Hermiedapwdrman/CH_Fishinator/firmware/samd_pio_src/ReadMe_Firmware_SAMD.md

##TO DO: Explain SAMD21 project src structure readme
1. Explaing how to init project via clion and platformio
2. Make some suggestions for configuring
3. Notes on commiting and tracking changes (ala esp32 readme)
4. profit!
