Hermiedapwdrman/CH_Fishinator/hardware/LogicBoard/BOM_LogicBoard.ods

Description: | Amount: | Manufacturer: | Manufacturer PN:Digikey | Other PN: | Website:
Boards, cables and and mechanics:
Esp pico kit v4 | 1 | Espressif – Electrodragon | NWI1145 |  | http://www.electrodragon.com/product/esp32-pico-kit-dev-board-v4/
Sparkfun SAMD21 mini break out board | 1 | Sparkfun Atmel | 13664 |  | https://www.sparkfun.com/products/13664
Ion Roboclaw 15A Motor Controller | 1 | Ion Motion Control | IMC412 |  | http://www.ionmc.com/RoboClaw-2x15A-Motor-Controller_p_10.html
1 ft cat 6e patch cable – shielded | 1 | Monoprince | 5898 |  | https://www.monoprice.com/product?p_id=5901
6ft USB A-B cable | 1 | Amazon |  |  | https://www.amazon.com/gp/product/B00UNZ9KBM/ref=oh_aui_detailpage_o01_s00?ie=UTF8&psc=1
1F USB A to micro | 1 |  |  |  | https://www.amazon.com/gp/product/B011KMSNXM/ref=oh_aui_detailpage_o01_s00?ie=UTF8&psc=1
Electronic components.
CUI AMT encoder wide base | 1 | CUI | AMT-B1-W | 102-3323-ND | https://www.digikey.com/products/en?keywords=102-3323-ND
CUI AMT-203 encoder | 1 | CUI | 102-2050-ND | 102-2050-ND | https://www.digikey.com/products/en/sensors-transducers/encoders/507?k=cui%20amt-203
USB Panel Adapter | 1 |  | SAM8637-ND |  | https://www.digikey.com/product-detail/en/samtec-inc/SCRU-02/SAM8637-ND/1785888
1uf 0603 capacitor | 3 | Taiyo Yuden | 587-2400-1-ND | UMK107BJ105KA-T | https://www.digikey.com/product-detail/en/taiyo-yuden/UMK107BJ105KA-T/587-2400-1-ND/2179013
0.1uf 0603 capacitor | 3 | Murata | 490-11917-1-ND |  | https://www.digikey.com/product-detail/en/samsung-electro-mechanics/CL10B104KB8SFNC/1276-1936-1-ND/3890022
10uf 1205 capacitor | 2 | Taiyo Yuden | 587-3248-1-ND | UMK316BBJ106ML-T | https://www.digikey.com/product-detail/en/murata-electronics-north-america/GRM155R61H104KE19D/490-11917-1-ND/5360889
470uf Through Elec. Capacitor | 1 | Panasonic elec. Components | P5185-ND | ECA-1HM471 | https://www.digikey.com/products/en/capacitors/aluminum-electrolytic-capacitors/58?k=p5185
Terminal blocks 2 position | 2 |  | 281-1414-ND | 1715250000 | https://www.digikey.com/products/en?keywords=281-1414
2x female square header socket | 2 | PRT-00115 |  |  | https://www.sparkfun.com/products/115
2x7 1.27mm fem header | 1 | Minitek | 20021311-00014T4LF | 609-3756-ND | https://www.digikey.com/product-detail/en/amphenol-fci/20021311-00014T4LF/609-3756-ND/2209089
RJ45 jack/socket, ethernet jack | 2 | Assamann WSW | A-2004-2-4-LPS-N-R | AE10387-ND | https://www.digikey.com/product-detail/en/assmann-wsw-components/A-2004-2-4-LPS-N-R/AE10387-ND/2183638
15.8k 0603 resistor | 1 |  | 311-15.8KHRCT-ND | RC0603FR-0715K8L | https://www.digikey.com/product-detail/en/yageo/RC0603FR-0715K8L/311-15.8KHRCT-ND/729904
33k resistor pack | 1 |  | 742C163333JPCT-ND |  | https://www.digikey.com/product-detail/en/cts-resistor-products/742C163333JP/742C163333JPCT-ND/1124501
Bss138P Transistor | 1 | Nexperia | 1727-1142-1-ND | BSS138P,215 | https://www.digikey.com/product-detail/en/nexperia-usa-inc/BSS138P215/1727-1142-1-ND/4162471
CSD Next fet Nfet transistor | 1 | Texes Inst. | 296-35628-1-ND | CSD18532Q5B | https://www.digikey.com/product-detail/en/texas-instruments/CSD18532Q5B/296-35628-1-ND/3854689
85V shottkey diode | 1 | Diodes inc. | MBR0580S1-7DICT-ND |  | https://www.digikey.com/product-detail/en/diodes-incorporated/MBR0580S1-7/MBR0580S1-7DICT-ND/5080371
