Hermiedapwdrman/CH_Fishinator/hardware/EncoderBoard/BOM_EncoderBoard.ods

Description: | Amount: | Manufacturer: | Manufacturer PN | Digikey or other PN: | Website:
2x7 1.27mm fem header | 1 | Minitek | 20021311-00014T4LF | 609-3756-ND | https://www.digikey.com/product-detail/en/amphenol-fci/20021311-00014T4LF/609-3756-ND/2209089
RJ45 jack/socket, ethernet jack | 1 | Assamann WSW | A-2004-2-4-LPS-N-R | AE10387-ND | https://www.digikey.com/product-detail/en/assmann-wsw-components/A-2004-2-4-LPS-N-R/AE10387-ND/2183638
1 ft cat 6e patch cable – shielded | 1 | Monoprince | 5898 |  | https://www.monoprice.com/product?p_id=5901
Esp pico kit v4 | 1 | Espressif – Electrodragon |  | NWI1145 | http://www.electrodragon.com/product/esp32-pico-kit-dev-board-v4/
