Hermiedapwdrman/CH_Fishinator/TODO.md

TODO: Example project for new organization

# A heading
## A sub heading

'Code snippet'
