Hermiedapwdrman/CH_Fishinator/hardware/LogicBoard/LogicBoard_ESP_SAMD.brd

## EAGLE design hardware/LogicBoard/LogicBoard_ESP_SAMD.brd (2018-03-26)

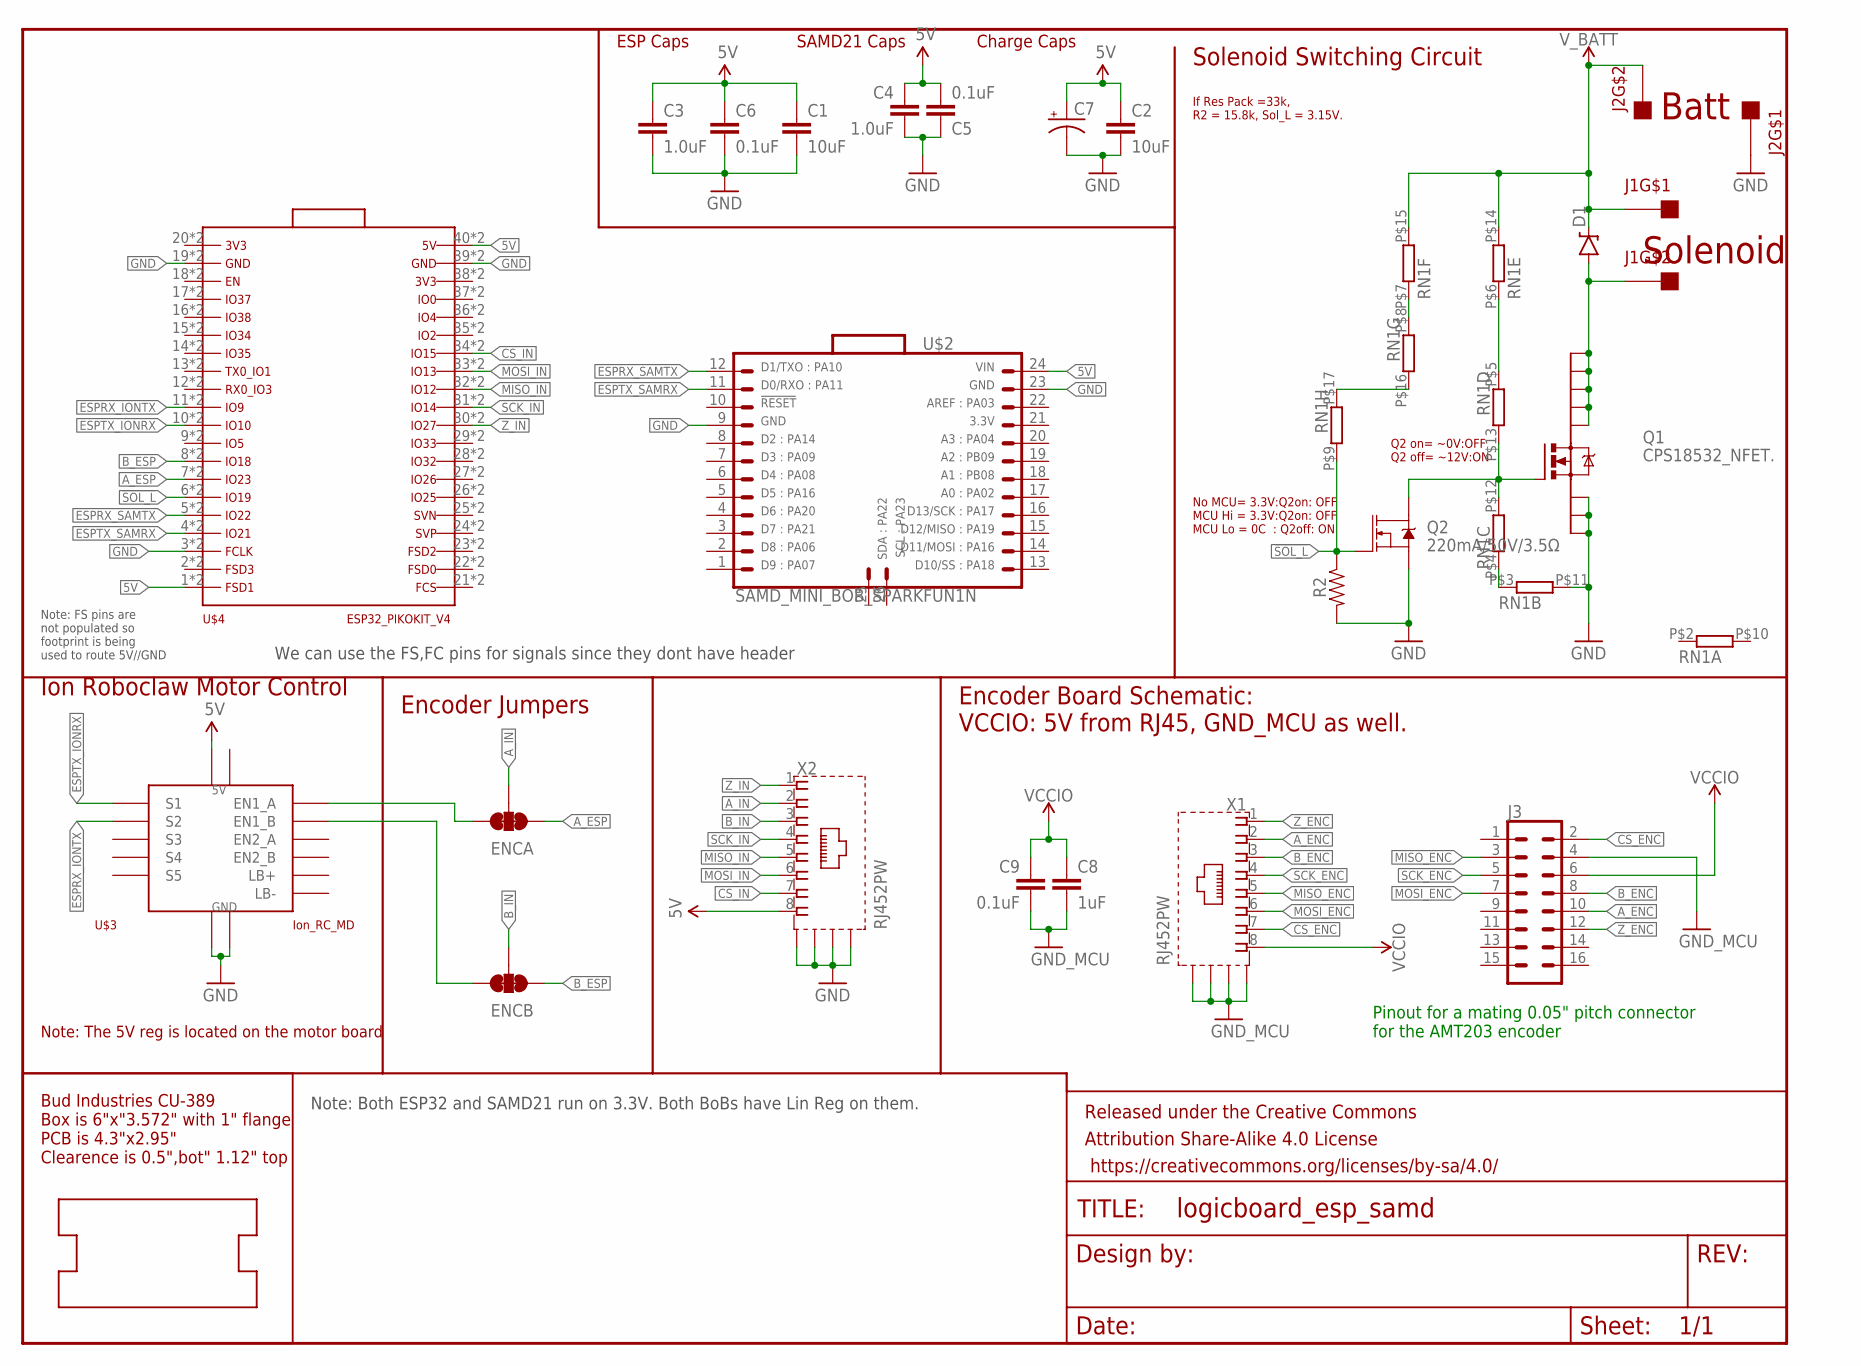
[picture p1: schematic LogicBoard_ESP_SAMD.sch]

Parts:
C1, C2: 10uF; 1206
C3, C4: 1.0uF; 0603
C5, C6, C9: 0.1uF; 0603
C7: CAP_POLPTH4; CPOL-RADIAL-1000UF-25V
C8: 1uF; 0603
D1: DIODE-SHOTKEY_SOD-123; SOD-123_MINI-SMA
ENCA: JUMPER-SMT_3_2-NC_TRACE_SILK; SMT-JUMPER_3_2-NC_TRACE_SILK
ENCB: JUMPER-SMT_3_2-NC_TRACE_SILK; SMT-JUMPER_3_2-NC_TRACE_SILK
FRAME1: FRAME-LETTERNO_PACKAGE; DUMMY
J1, J2: M2_TERMINAL_0200SPACING; M2_0200
J3: CONN_08X2_1.27MM; 2X08_1.27MM
Q1: CPS18532_NFET.; CSD18532_NFET_NEXTFET
Q2: 220mA/50V/3.5Ω; SOT23-3
R2: 0603
RN1: RESISTOR-DIL_8R-N742C163; RESISTOR-DIL_742C163
U$1: BOX_BUDIND_CU389STENCIL; BOX_BUDIND_CU389_STENCIL
U$2: SAMD_MINI_BOB_SPARKFUN1N; SAMD_MINI_BOB_SF_NOLABEL
U$3: ION_ROBOCLAW_MOTORDRVTOPVIEW; ION_ROBOCLAW_MOTORCNTL
U$4: ESP32_PICOKIT_V42N; ESP32_PICOKIT_2N
X1, X2: RJ452PW; RJ45-SHIELD1

Connections:
5V: C1.1, C2.1, C3.1, C4.1, C5.2, C6.1, C7.1 (+), U$2.24 (VIN), U$3.5V@1 (5V), U$3.5V@2 (5V), U$3.5V@3 (5V), U$3.5V@4 (5V), U$3.5V@5 (5V), U$4.1, U$4.40, U$4.41, U$4.80, X2.8
!SOL_L!: Q2.1 (G), R2.1, RN1.P$9 (2), U$4.6, U$4.46
A_ENC: J3.10, X1.2
A_ESP: ENCA.1, U$4.7, U$4.47
A_IN: ENCA.2, X2.2
B_ENC: J3.8, X1.3
B_ESP: ENCB.1, U$4.8, U$4.48
B_IN: ENCB.2, X2.3
CS_ENC: J3.2, X1.7
CS_IN: U$4.34, U$4.74, X2.7
ESPRX_IONTX: U$3.S2, U$4.11, U$4.51
ESPRX_SAMTX: U$2.12 (D1), U$4.5, U$4.45
ESPTX_IONRX: U$3.S1, U$4.10, U$4.50
ESPTX_SAMRX: U$2.11 (D0), U$4.4, U$4.44
GND: C1.2, C2.2, C3.2, C4.2, C5.1, C6.2, C7.2 (-), J2.P$2, Q1.P$1 (S1), Q1.P$2 (S2), Q1.P$3 (S3), Q2.2 (S), R2.2, RN1.P$11 (2), U$2.9 (GND), U$2.23 (GND), U$3.GND@1 (GND), U$3.GND@2 (GND), U$3.GND@3 (GND), U$3.GND@4 (GND), U$3.GND@5 (GND), U$3.GND@6 (GND), U$3.GND@7 (GND), U$4.3, U$4.19, U$4.39, U$4.43, U$4.59, U$4.79, X2.S1 (S), X2.S2 (S), X2.S3 (S), X2.S4 (S)
GND_MCU: C8.2, C9.2, J3.4, X1.S1 (S), X1.S2 (S), X1.S3 (S), X1.S4 (S)
MISO_ENC: J3.3, X1.5
MISO_IN: U$4.32, U$4.72, X2.5
MOSI_ENC: J3.7, X1.6
MOSI_IN: U$4.33, U$4.73, X2.6
unnamed: D1.A, J1.P$3, Q1.P$5 (D1), Q1.P$6 (D2), Q1.P$7 (D3), Q1.P$8 (D4), Q1.P$9 (D_PAD)
unnamed: RN1.P$3 (1), RN1.P$4 (1)
unnamed: Q1.P$4 (G), Q2.3 (D), RN1.P$12 (2), RN1.P$13 (2)
unnamed: RN1.P$7 (1), RN1.P$8 (1)
unnamed: RN1.P$16 (2), RN1.P$17 (1)
unnamed: RN1.P$5 (1), RN1.P$6 (1)
unnamed: ENCB.3, U$3.EN1_B
unnamed: ENCA.3, U$3.EN1_A
SCK_ENC: J3.5, X1.4
SCK_IN: U$4.31, U$4.71, X2.4
VCCIO: C8.1, C9.1, J3.6, X1.8
V_BATT: D1.C, J1.P$2, J2.P$3, RN1.P$14 (2), RN1.P$15 (2)
Z_ENC: J3.12, X1.1
Z_IN: U$4.30, U$4.70, X2.1

Notes on the sheet:
Note: Both ESP32 and SAMD21 run on 3.3V. Both BoBs have Lin Reg on them.
We can use the FS,FC pins for signals since they dont have header
Pinout for a mating 0.05" pitch connector for the AMT203 encoder
Encoder Board Schematic: VCCIO: 5V from RJ45, GND_MCU as well.
If Res Pack =33k, R2 = 15.8k, Sol_L = 3.15V.
Encoder Jumpers
Ion Roboclaw Motor Control
Note: The 5V reg is located on the motor board
Solenoid Switching Circuit
Solenoid
Batt
Q2 on= ~0V:OFF Q2 off= ~12V:ON
No MCU= 3.3V:Q2on: OFF MCU Hi = 3.3V:Q2on: OFF MCU Lo = 0C : Q2off: ON
ESP Caps
SAMD21 Caps
Charge Caps
Note: FS pins are not populated so footprint is being used to route 5V//GND

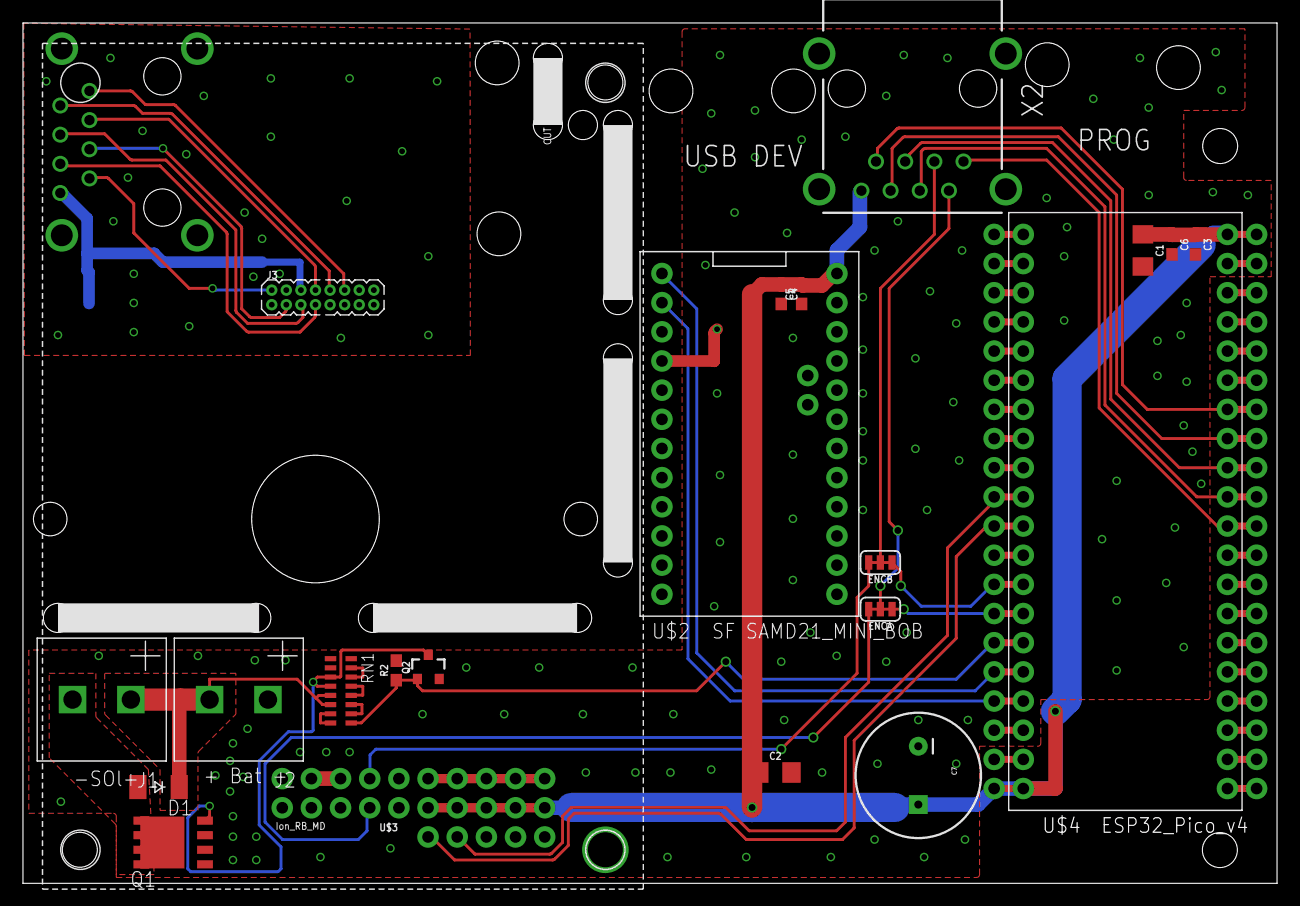
[picture p2: board LogicBoard_ESP_SAMD.brd from above]

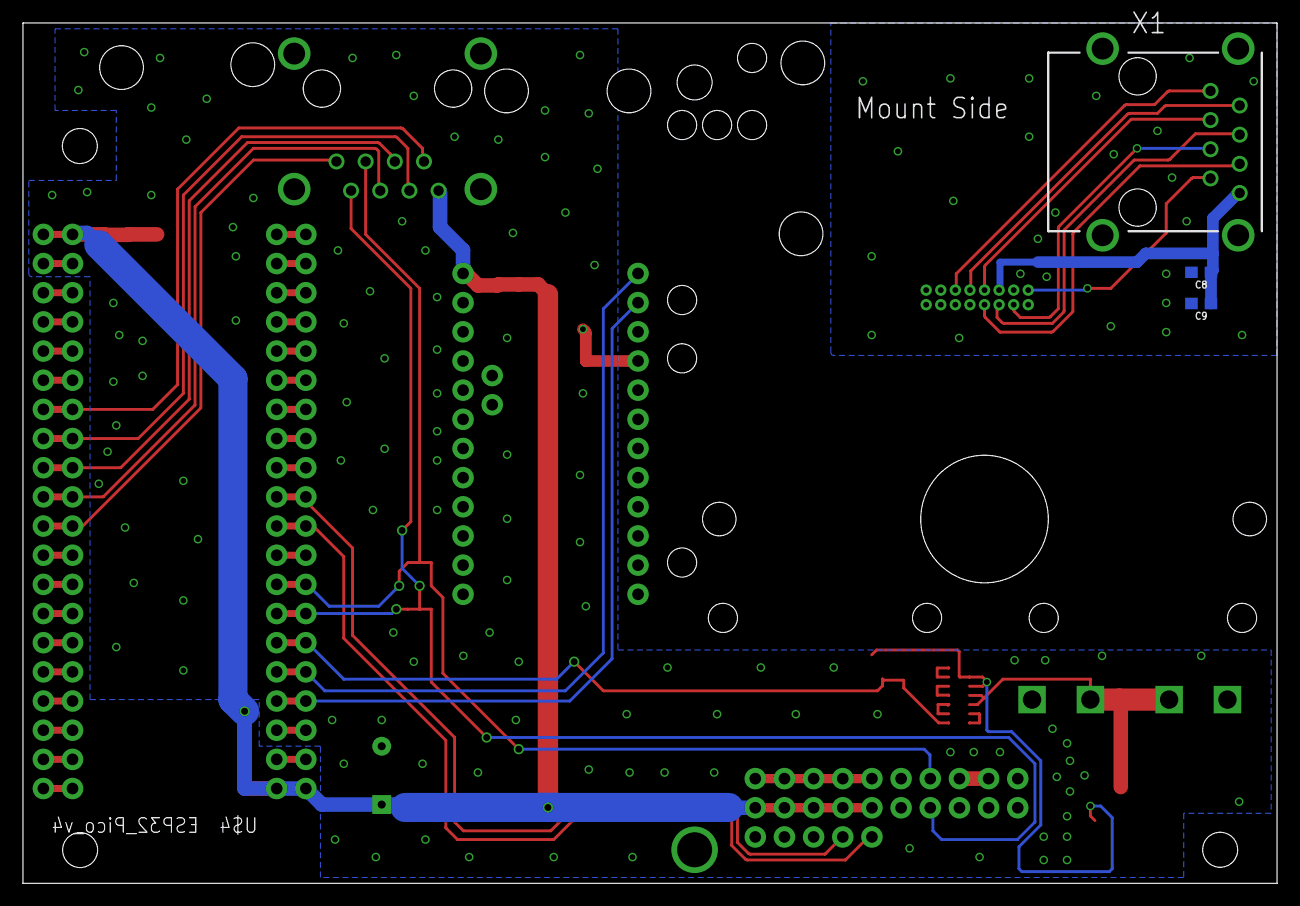
[picture p3: board LogicBoard_ESP_SAMD.brd from below]

Board: 2 copper layers, 109.2 x 74.9 mm, 27 parts (3 on the bottom side), 34 nets.

Other parts of the board:
FRAME2: FRAME-LETTERNO_PACKAGE; DUMMY
