Hermiedapwdrman/CH_Fishinator/hardware/EncoderBoard/EncAMT203_Cat6_180223.brd

## EAGLE design hardware/EncoderBoard/EncAMT203_Cat6_180223.brd (2018-02-27)

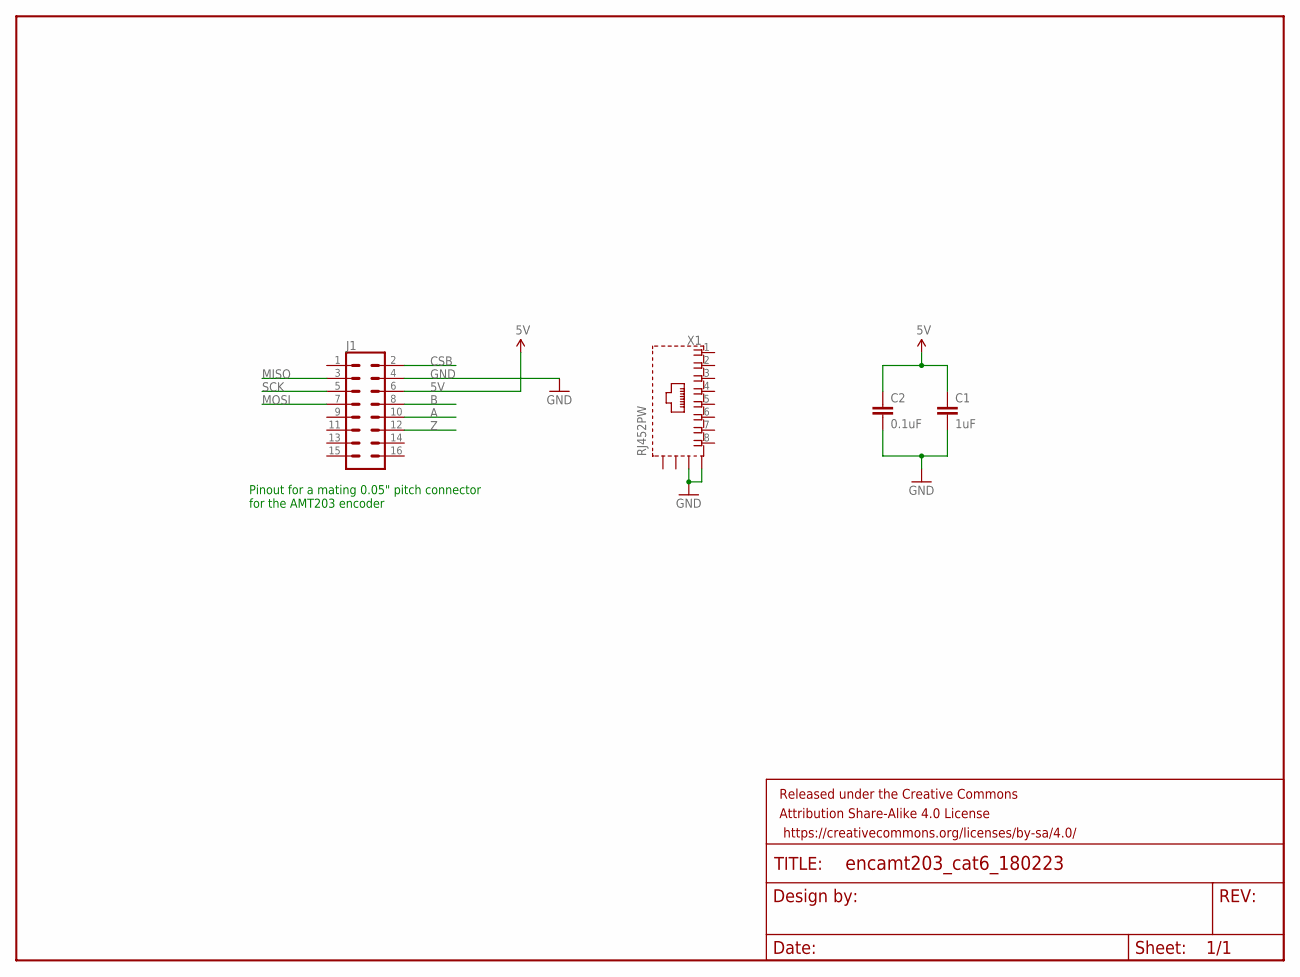
[picture p4: schematic EncAMT203_Cat6_180223.sch]

Parts:
C1: 1uF; 0603
C2: 0.1uF; 0603
FRAME1: FRAME-LETTERNO_PACKAGE; DUMMY
J1: CONN_08X2_1.27MM; 2X08_1.27MM
X1: RJ452PW; RJ45-SHIELD1

Connections:
5V: C1.1, C2.1, J1.6
A: J1.10
B: J1.8
CSB: J1.2
GND: C1.2, C2.2, J1.4, X1.S1 (S), X1.S2 (S)
MISO: J1.3
MOSI: J1.7
SCK: J1.5
Z: J1.12

Notes on the sheet:
Pinout for a mating 0.05" pitch connector for the AMT203 encoder

Board: 2 copper layers, 5 parts (3 on the bottom side), 2 nets, no tracks yet.
