Hermiedapwdrman/CH_Fishinator/(commit log)

2017-11-01 Initial commit for a combined LUFA/AT90 and ESP32 MCU project.
2017-11-01 Tested build for ESP32 files, it works.
2017-11-01 Updated esp32 git ignore.
2017-11-15 Clarified project names, and updated sdkconfig UART settings to run at 921600 for everthing!
2017-12-13 New initial commit: Using git submodules to track sdk versions and make code more'complete'
2017-12-20 Changed paths to local git repos of big esp32 sdks
2018-01-08 Updated configs and updated submodules to track certain maintainable branches
2018-01-09 Added raw motor_vpid code into project, added arduino pid library as component submodule.
2018-01-12 Updating submodules, moved VPID and Pid to its own library
2018-01-12 Fixed cmake indexer includes, commented out LOTS of non portable code: NEEDS TO BE FIXED
    [CHMotorDriver.cpp]
2018-01-22 Updated arduino to master branch and FF to current
2018-01-22 Updated edp-idf to newest, compaitble with arduino
2018-01-22 Updated arduino sdk
2018-02-02 Updated cmake idf includes for components drivers, changed and test built idf syntax with arduino as component.
2018-02-07 Merge remote-tracking branch 'template_local/master' into Motor_VPID_Integration
    # Conflicts:
    # firmware/esp_src/ReadMe_Components.md
    # firmware/esp_src/components/esp-idf
    # firmware/esp_src/sdkconfig.old
2018-02-07 Roughed out case statement for testing casting.
2018-02-08 Diactivated arduino init, working peripherial commands for test. Solenoid, reel, move cast location. no working implementaion of rod motor.
2018-02-08 Working encoder implementation (CAUTION has gone strange before.), getchar and other peripherials.
2018-02-09 Moved encoder isr to main function due to solenoid handling. Added cast sequence to main casting function. Made rtos tick at 1000hz, not sure if its needed though
2018-02-21 Added ESP32 snippets as base library to the template, good examples and utils.
2018-02-27 Copied over usb descripter example from arduino sam library. Compiles
2018-02-27 Added exp to find serial ports, SerialUSB for usb device comm, Serial 1 for breakout on board.
2018-02-27 Replaceds seraial monitor macro with hardware port(ser1), which is broken out on sf board
2018-02-27 Started working on circuit and hardware design, included datasheets
    [BOM_EncoderBoard.ods, EncAMT203_Cat6_180223.brd, EncAMT203_Cat6_180223.sch]
2018-02-27 Working communication between samd on serial1 and esp on uart2!
2018-02-27 Using test code for usb desc, will read a usb device on startu succesfully.
2018-02-28 Adjust esp read code,(need to switch to idf buffer), test descripter reads successfully.
2018-02-28 Move uart comm on esp to espidf function calls, better control.
2018-03-09 Added hardware (eagle) sch and brd files
    [LogicBoard_ESP_SAMD.brd, LogicBoard_ESP_SAMD.sch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]
2018-03-26 Updated pinouts for fishing rod beta 2. Updated sdk versions, carried forward firmware docs.
    [BOM_LogicBoard.ods, LogicBoard_ESP_SAMD.brd, LogicBoard_ESP_SAMD.sch, Logic_board_partslist.csv, Logic_board_partslist.ods]
2018-03-27 Started cleaning up code, added fish prompts and printouts for layman use.
2018-03-27 Updated terminal help printout, and some info printouts for state machine, added emergency stop.
2018-03-27 Added kludgy decay timers for smoother reel and rod manual control. Added user methods for setting positions, and other methods. Some reset checks
    [fish_prompts.h, mymain.cpp]
2018-03-27 Added date rev, fixed some prompts.
    [fish_prompts.h, mymain.cpp]
2018-03-27 Fixed typos, added splash and changed function a bit.
    [fish_prompts.h, mymain.cpp]
2018-03-30 Fixed some ui keymaps; state debouncing to prevent changings states too fast.
    [fish_prompts.h, mymain.cpp]
2018-03-30 Minor fix on casting location check, updated sdk config.
    [mymain.cpp]
